Leilazehui/CANSAT/Introduction.md

**Test**: next thursday - theories and equations, mission plan and technology 

**Venue**: MAR Building

**Lab**: Opposite street of MAR building

22 July 2026
---
Satellite construction, standards: types, advantages and disadvantages of sizes; cell phone component
---
**subsystem of the satellites:**

bus
- Elec. Power Supp
- Thermal
- Attitude
- OBC
- TT&X
- Propusion
- Structure

---
Payload
- Sci. Instr.
- Transponder
- Meterological Inst.
- Navigat
- Military
---

EPS:
- Solar generator
- Thermoelectric Radioisotope Thermoelectric Generator (RTC): to provide heat and energy when probes are far away from the Earth, e.g., Mars rovers

Attitude control:
- optical fibre for attitude calculation 

AOCS Actuators:
- Flying wheels
- Magnetic actuators
- Control momentum gyro
- reaction control thruster (CHEMICAL)

Propulsion: Cold vs Hot Gas
---
Hot gas:
- Mono propellant
- Bi propellant: Kerosene, mathane, hydrogen etc + Oxygen
- Solid propellant boosters: **study the N-t diagram of thrust of solid fuel of the rocket** (good side: enormous amount of thrust; down side: cannot be regulated)
- Ion propulsion: Xenon ion pushed by electron
- Solar sails: photons

Structures and mechanisms:
- deployment, folding spring mechanism for modules, e.g., solar panels, antenna

---
Contact to Ground station: Berlin and Hainan? OCI project?

**Ground station at poles:**
- Svalbard in north pole, san martin base in south pole
---
Cost of space launches:
- Source: Our world in data
- heavy payload - falcon series: 2000 dollar /kg
- medium to light payload - 2000-6000 dollar/kg
---
Consequences of space derbis: keslar syndrom? need to clean the space debris to make sure the launch arent hindered by them.

23 July 2026 Electrical engineering 
---

- Avalanche
- Read the code of resistor 
- SMD resistor: surface mounted device resistor
- study eletrcical theories, laws and equations: ohm's law, kirchoff's law,

Prepare powerpoint presentation (around 8 minutes) on next week:
- team management: introduce team members, name of the team, communication within team
- work breakdown structure (with responsibilities), work shcedule
- first concept ideas (cansat, parachute removal)
- requirements and objectives

---
