Leilazehui/CANSAT/Electrical/CanSat Electrical Diagram .pdf

## CanSat Project — Team Sternenjäger01

Electrical Subsystem — Complete Wiring Diagram (Rev. 1)

Electronics & Power Systems Lead TU Berlin CanSat Summer School

### Arduino UNO

3V3

A1

A2

A3

5V

VIN

A0

A4 (SDA)

A5 (SCL)

D13

D12

D11

D10

D8

D9

D7 (CAM RX)

D6 (CAM TX)

D5

D4

D3

D2

D1 (TX)

D0 (RX)

GND

### 9V battery

+ = VIN, − = GND

### BMP280

altitude sensor

GY-521
acceleration sensor

LM35
temperature sensor

I2C — shared, parallel

5V bus — from Arduino, shared (parallel) raw 9V direct — bypasses the 5V bus (motor driver + camera)

### Servo (SG90)

parachute release

### XBee (+ Explorer)

DIN / DOUT

### Motor driver

IN1-IN4 = D2-D5
power: raw battery

### ESP32-CAM

power: raw battery
D6/D7 = SoftwareSerial

### Legend

Solid red = 5V bus (shared, parallel) · Dashed red = raw 9V direct from battery Gray = GND — common return, shared by everything
Blue = I2C bus (BMP280 + GY-521 share A4/A5, in parallel)
Orange = LM35 analog signal (A0, dedicated wire)
Purple = servo signal (D9, dedicated wire)

Teal = XBee TX/RX (D0/D1 — disconnect before uploading code)
Green = motor driver control (D2–D5, dedicated wires)
Magenta = ESP32-CAM serial (D6/D7 via SoftwareSerial — kept off D0/D1 to avoid conflict with the XBee) Gray pin labels (3V3, A1–A3, D8, D10–D13) = unused pins, no wire connected

Lines that cross without a junction dot are NOT connected — different nets simply pass over each other.
Motor driver and ESP32-CAM are powered directly from the battery (raw 9V) to avoid current spikes disturbing the sensor readings. All grounds (GND) are common across the whole circuit — battery, Arduino, and every component share the same return path.
