Leilazehui/CANSAT/Mechanical/CanSat Chassis 3.STL

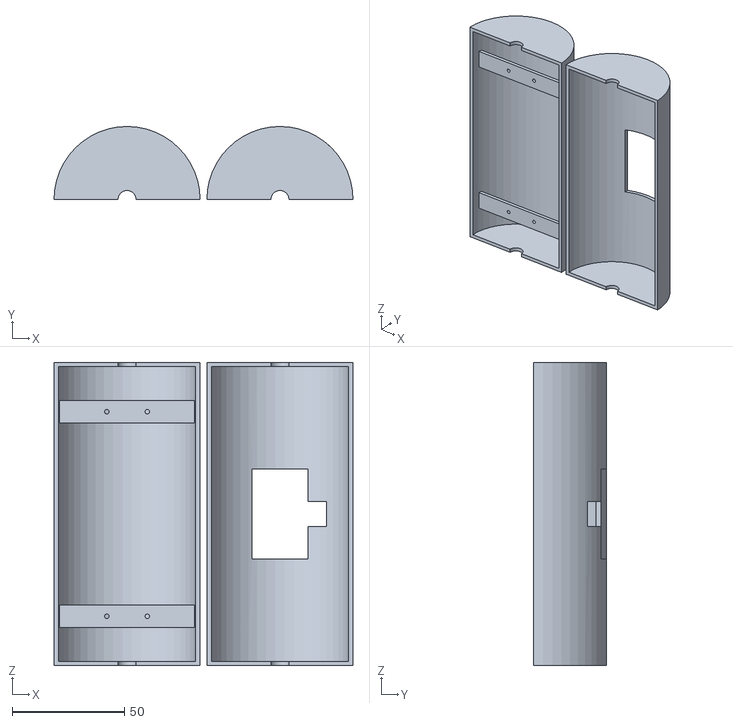
[picture p1: CAD file, 2026-08-10]
Mechanical/CanSat Chassis 3.STL
133.0 x 32.5 x 135.0
