Leilazehui/CANSAT/Mechanical/Parachute Hoop v3.STL

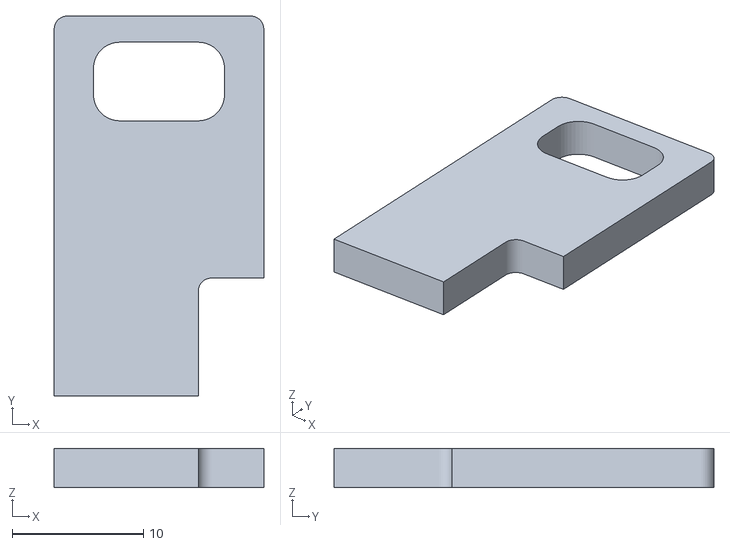
[picture p2: CAD file, 2026-08-06]
Mechanical/Parachute Hoop v3.STL
16.0 x 29.0 x 3.00
