Leilazehui/CANSAT/Mechanical/Parachute Latch v3.STL

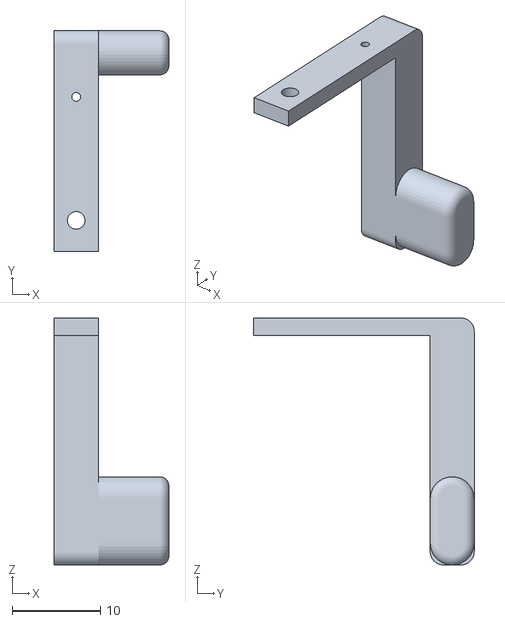
[picture p3: CAD file, 2026-08-06]
Mechanical/Parachute Latch v3.STL
13.0 x 25.0 x 28.0
