Leilazehui/CANSAT/Mechanical/CanSat Chasis 2.STL

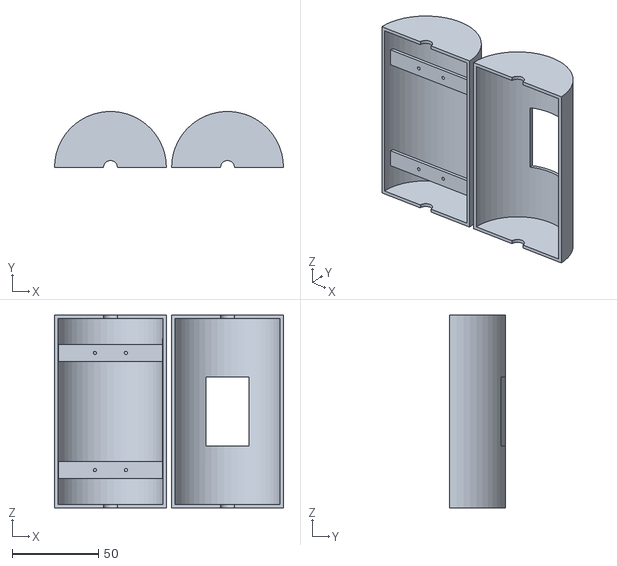
[picture p4: CAD file, 2026-08-04]
Mechanical/CanSat Chasis 2.STL
133.0 x 32.4 x 112.0
