Leilazehui/CANSAT/Mechanical/Parachute Hoop.3mf

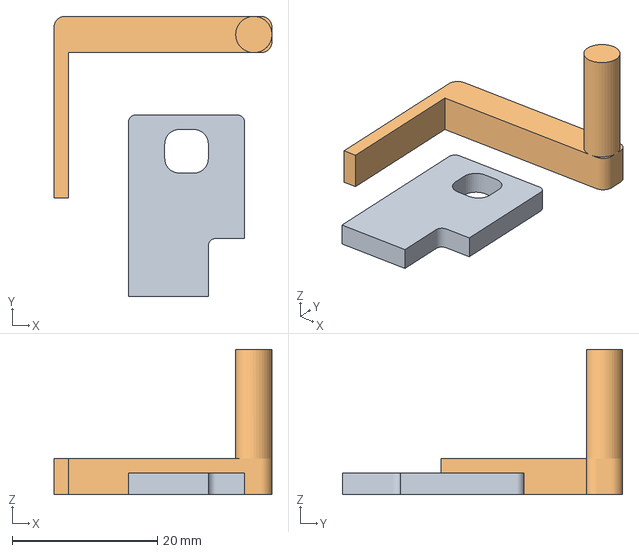
[picture p5: CAD file, 2026-08-03]
Mechanical/Parachute Hoop.3mf
30.0 x 38.6 x 20.0 mm
Parachute Hoop.STL
Parachute Latch.STL
