Leilazehui/CANSAT/Mechanical/CanSat Chasis 1-2.STL

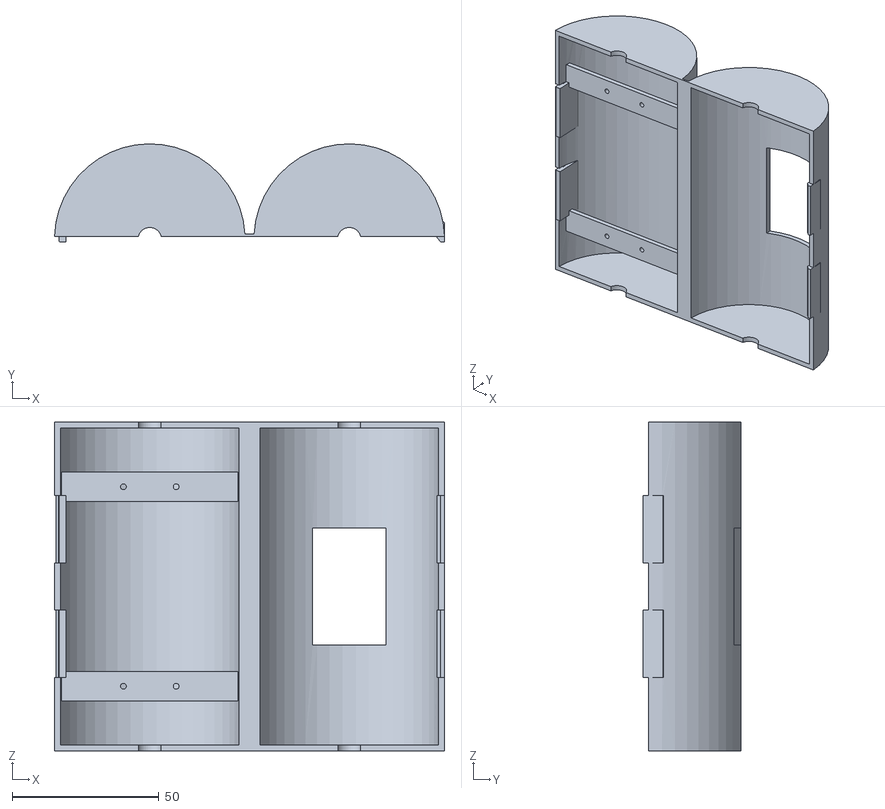
[picture p6: CAD file, 2026-07-30]
Mechanical/CanSat Chasis 1-2.STL
133.0 x 33.5 x 112.0
