Leilazehui/CANSAT/Mechanical/Parachute Latch v2.STL

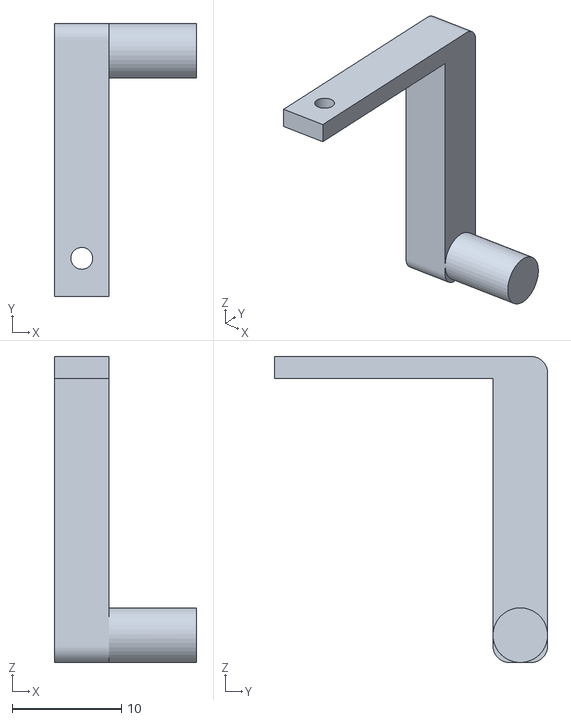
[picture p7: CAD file, 2026-08-06, an earlier design]
Mechanical/Parachute Latch v2.STL
13.0 x 25.0 x 28.0
