Leilazehui/CANSAT/Mechanical/Parachute Hoop v2.STL

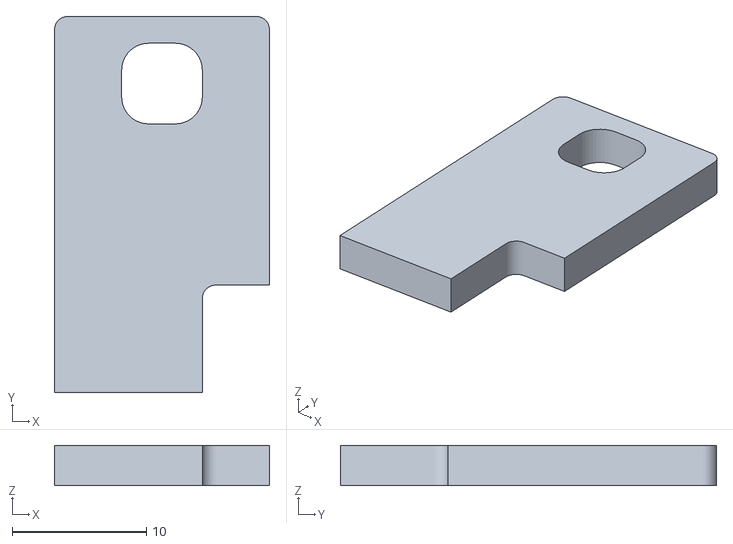
[picture p8: CAD file, 2026-08-06, an earlier design]
Mechanical/Parachute Hoop v2.STL
16.0 x 28.0 x 3.00
