Leilazehui/CANSAT/Mechanical/Parachute Latch.STL

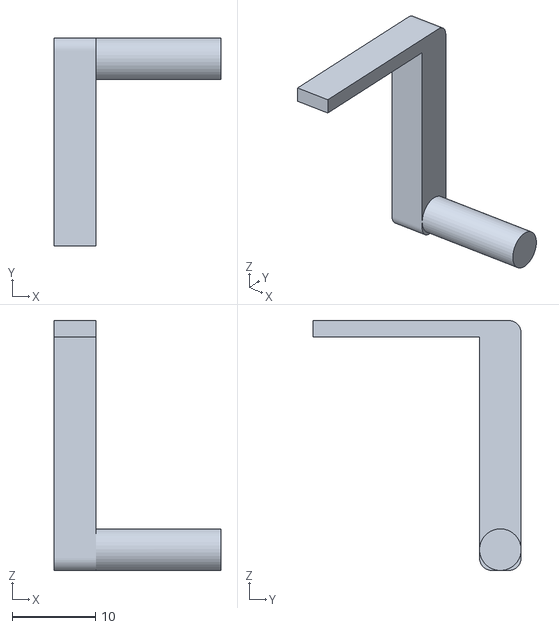
[picture p9: CAD file, 2026-08-03, an earlier design]
Mechanical/Parachute Latch.STL
20.0 x 25.0 x 30.0
