Leilazehui/CANSAT/(list of files, cad)

Other CAD files:
Mechanical/CanSat Chassis 3.gcode.3mf
Mechanical/Parachute Hoop & Latch v2.gcode.3mf
Mechanical/Parachute Hoop and Latch .gcode.3mf
Mechanical/Parachute Hoop.STL
