Leilazehui/CANSAT/Oldcode/Altitude.h

#ifndef ALTITUDE_H
#define ALTITUDE_H

void initAltitude();

void updateAltitude();

float getCurrentAltitude();

float getRelativeAltitude();

float getMaxAltitude();

float getVerticalSpeed();

#endif
