Leilazehui/CANSAT/(commit log)

2026-07-28 Create Simple LED Blinking Test.cpp
2026-07-28 Rename Simple LED Blinking Test.cpp to Simple-LED-Blinking-Test.cpp
2026-07-30 CanSat Chasis V1 (.STL and .gcode)
    [CanSat Chasis 1-2.STL, CanSat Chasis 1.gcode.3mf]
2026-08-03 Parachute Mechanism Files
    [Parachute Hoop and Latch .gcode.3mf, Parachute Hoop.3mf, Parachute Hoop.STL, Parachute Latch.STL]
2026-08-04 Chassis v2 files + Latch and Hoop Drawings
    [CanSat Chasis 2.STL, CanSat Chasis 2.gcode.3mf]
2026-08-06 New Versions of Parachute Hoop & Parachute Latch
    [Parachute Hoop v2.STL, Parachute Latch v2.STL]
2026-08-06 Sliced version of latch & hoop files v2
    [Parachute Hoop & Latch v2.gcode.3mf]
2026-08-06 Version 3 of the parachute mechanism, pin is a bit wider for strength.
    [Parachute Hoop v3.STL, Parachute Latch v3.STL]
2026-08-10 Chassis v3 files
    [CanSat Chassis 3.STL, CanSat Chassis 3.gcode.3mf]
2026-08-29 Rename CanSat Chasis 1-2.STL to Mechanical/CanSat Chasis 1-2.STL
    [CanSat Chasis 1-2.STL]
2026-08-29 Rename CanSat Chasis 1.gcode.3mf to Mechanical/CanSat Chasis 1.gcode.3mf
    [CanSat Chasis 1.gcode.3mf]
2026-08-29 Rename CanSat Chassis 2.PDF to Mechanical/CanSat Chassis 2.PDF
2026-08-29 Rename CanSat Chasis 2.STL to Mechanical/CanSat Chasis 2.STL
    [CanSat Chasis 2.STL]
2026-08-29 Rename CanSat Chasis 2.gcode.3mf to Mechanical/CanSat Chasis 2.gcode.3mf
    [CanSat Chasis 2.gcode.3mf]
2026-08-29 Rename CanSat Chassis 3.STL to Mechanical/CanSat Chassis 3.STL
    [CanSat Chassis 3.STL]
2026-08-29 Rename CanSat Chassis 3.gcode.3mf to Mechanical/CanSat Chassis 3.gcode.3mf
    [CanSat Chassis 3.gcode.3mf]
2026-08-29 Rename CanSat Chassis 3.pdf to Mechanical/CanSat Chassis 3.pdf
2026-08-29 Rename Parachute Latch v2.STL to Mechanical/Parachute Latch v2.STL
    [Parachute Latch v2.STL]
2026-08-29 Rename Parachute Latch v3.STL to Mechanical/Parachute Latch v3.STL
    [Parachute Latch v3.STL]
2026-08-29 Rename Parachute Latch.STL to Mechanical/Parachute Latch.STL
    [Parachute Latch.STL]
2026-08-29 Rename Parachute Hoop.STL to Mechanical/Parachute Hoop.STL
    [Parachute Hoop.STL]
2026-08-29 Rename CanSat Pin Connections .pdf to Electrical/CanSat Pin Connections .pdf
2026-08-29 Rename Parachute Hoop & Latch v2.gcode.3mf to Mechanical/Parachute Hoop & Latch v2.gcode.3mf
    [Parachute Hoop & Latch v2.gcode.3mf]
2026-08-29 Rename Parachute Hoop v2.STL to Mechanical/Parachute Hoop v2.STL
    [Parachute Hoop v2.STL]
2026-08-29 Rename Parachute Hoop and Latch .gcode.3mf to Mechanical/Parachute Hoop and Latch .gcode.3mf
    [Parachute Hoop and Latch .gcode.3mf]
2026-08-29 Rename Parachute Hoop.3mf to Mechanical/Parachute Hoop.3mf
    [Parachute Hoop.3mf]
2026-08-29 Rename Parachute Hoop v3.STL to Mechanical/Parachute Hoop v3.STL
    [Parachute Hoop v3.STL]
